alejandroescobar264/morfometria_craneos/README.md

# morfometria_craneos
Adquisición y Análisis de Datos Morfométricos Craneales Multidimensionales

Mejor visualización visitar [Wiki](https://alejandroescobar264.github.io/morfometria_craneos/).
