alejandroescobar264/morfometria_craneos/docs/modelos.md

# Modelos

## Todos Juntos

Muestras procesadas

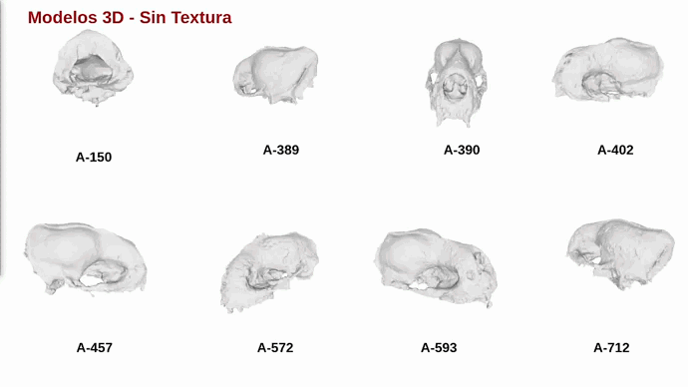
[picture p26: docs/img/GIF/Modelos_3D_Sin_Textura.gif]


## Individuales

### A-147

Muestras procesadas

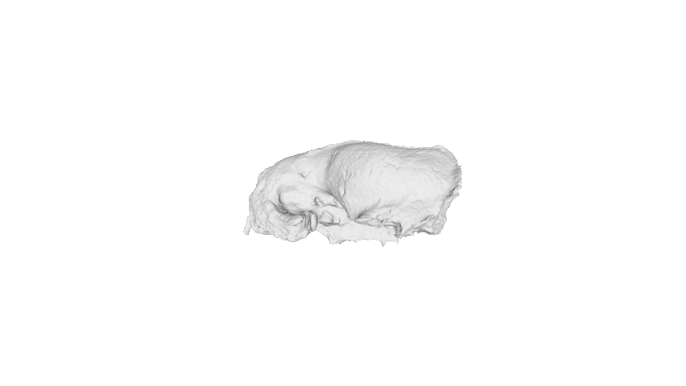
[picture p27: docs/img/GIF/A-147.gif]


### A-150

Muestras procesadas

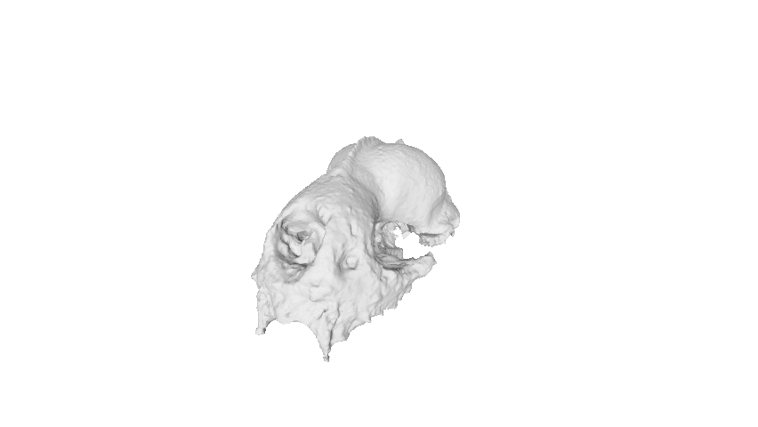
[picture p28: docs/img/GIF/A-150.gif]


### A-389

Muestras procesadas

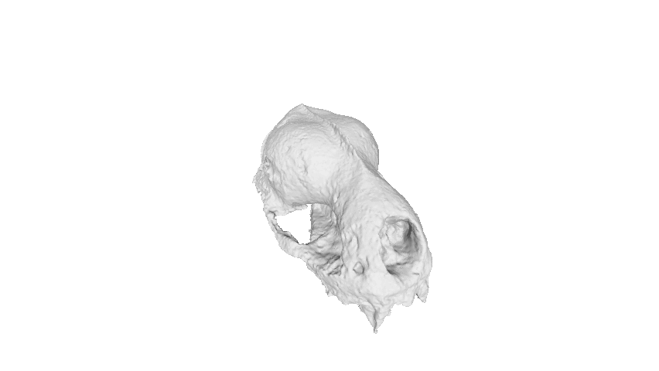
[picture p29: docs/img/GIF/A-389.gif]


### A-390

Muestras procesadas

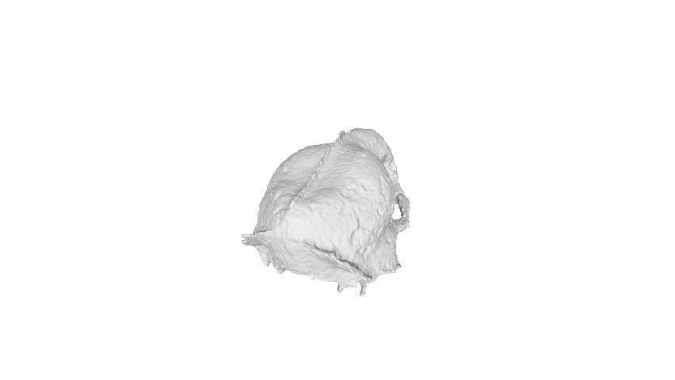
[picture p30: docs/img/GIF/A-390.gif]


### A-402

Muestras procesadas

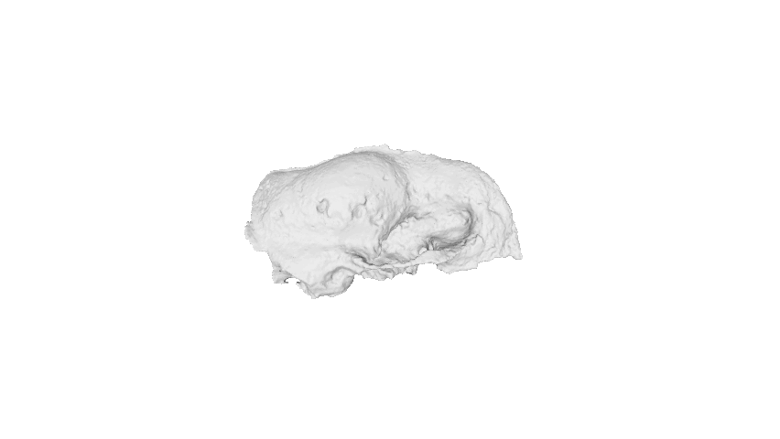
[picture p31: docs/img/GIF/A-402.gif]


### A-457

Muestras procesadas

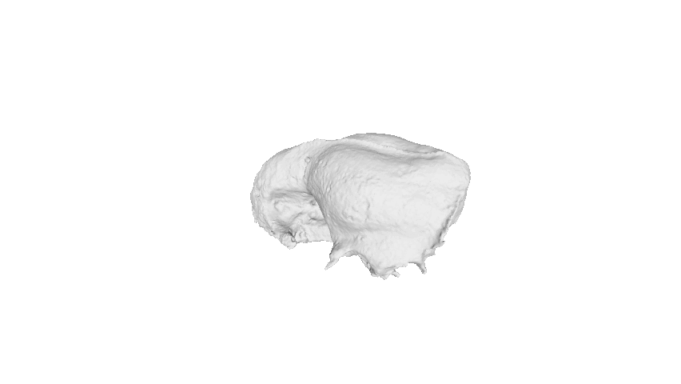
[picture p32: docs/img/GIF/A-457.gif]


### A-572

Muestras procesadas

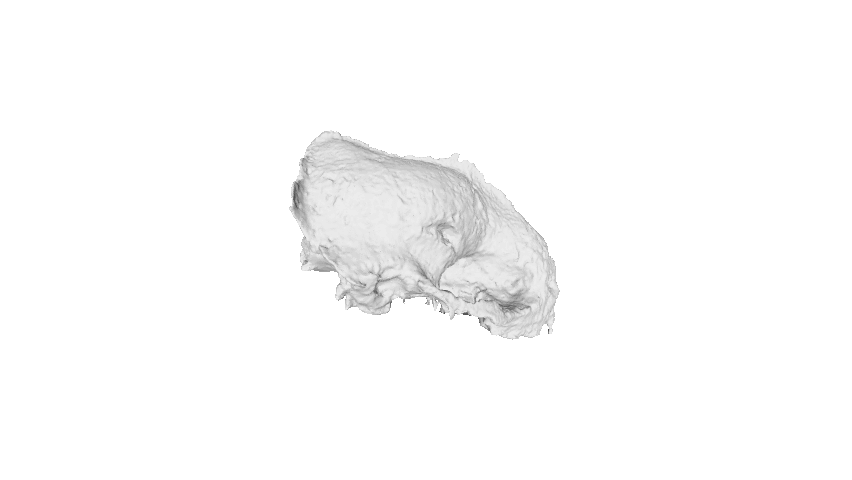
[picture p33: docs/img/GIF/A-572.gif]


### A-593

Muestras procesadas

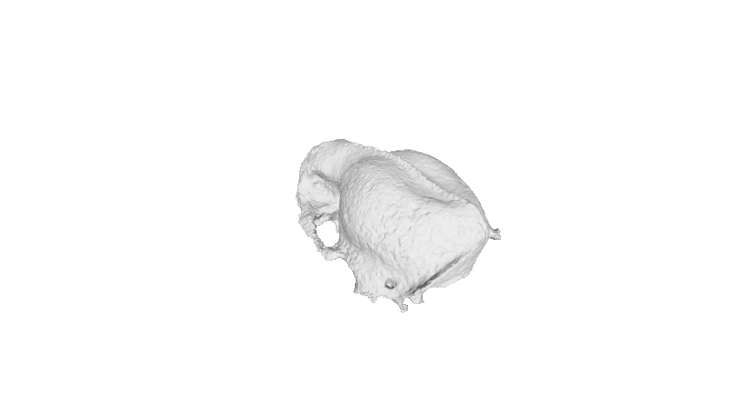
[picture p34: docs/img/GIF/A-593.gif]


### A-712

Muestras procesadas

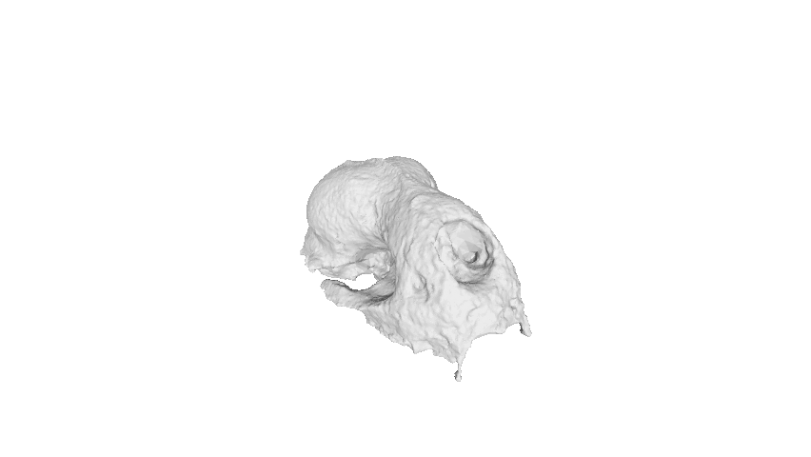
[picture p35: docs/img/GIF/A-712.gif]
