alejandroescobar264/morfometria_craneos/docs/resultado.md

# Resultados

## Versión 2.0

### Muestras Procesadas

Se observan a continuación las muestras elegidas:

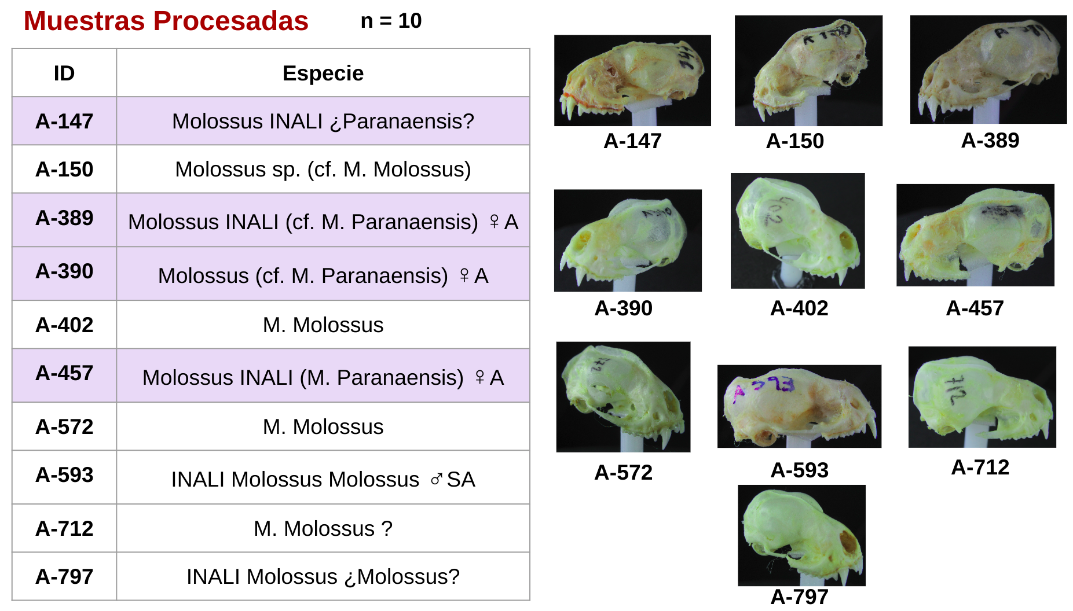
[picture p40: docs/img/muestras_procesadas.png]
Muestras procesadas


Se muestra a modo de ejemplo una de los modelos correspondiente a la muestra A-150, con y sin textura:

Muestras procesadas

Muestras procesadas

Las demás pueden observarse a continuación:

Muestras procesadas

Muestras procesadas

En el apartado de Modelos se pueden encontrar las muestras individuales.

## Análisis Morfométrico 3D

### Colocación de Landmarks 3D

Para la colocación de Landmarks se empleó el software libre 3D Slicer, particularmente la librería SliceMorph.

Se colocaron 24 landmarks craneales, 16 en el hueso nasal y 22 en la nuca.

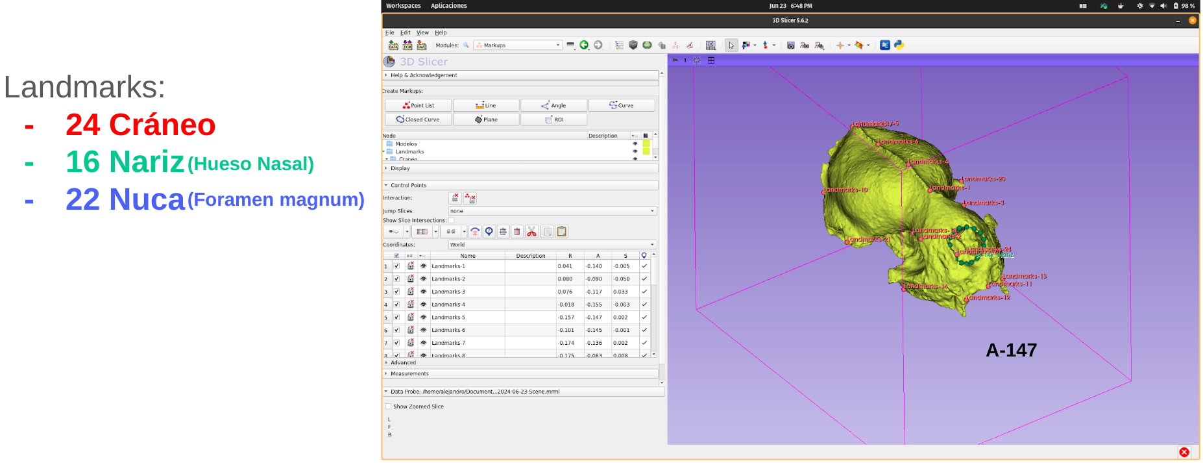
[picture p41: docs/img/3d_slicer.png]
3D Slicer - SliceMorph


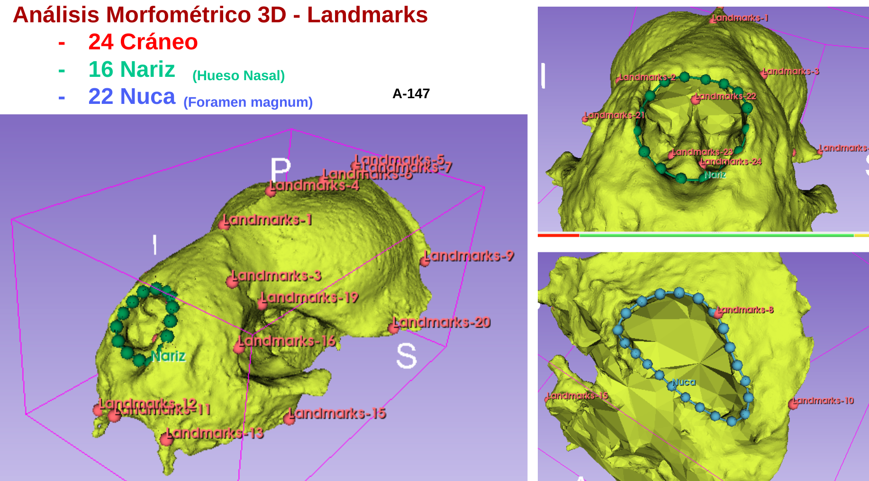
[picture p42: docs/img/landmarks.png]
Landmarks


Se empleó el complemento ALPACA para poder transferir los landmarks de una plantilla al resto de los modelos, ahorrando mucho tiempo de marcado manual.

Se muestran todo el conjunto de modelos con los landmarks transferidos.

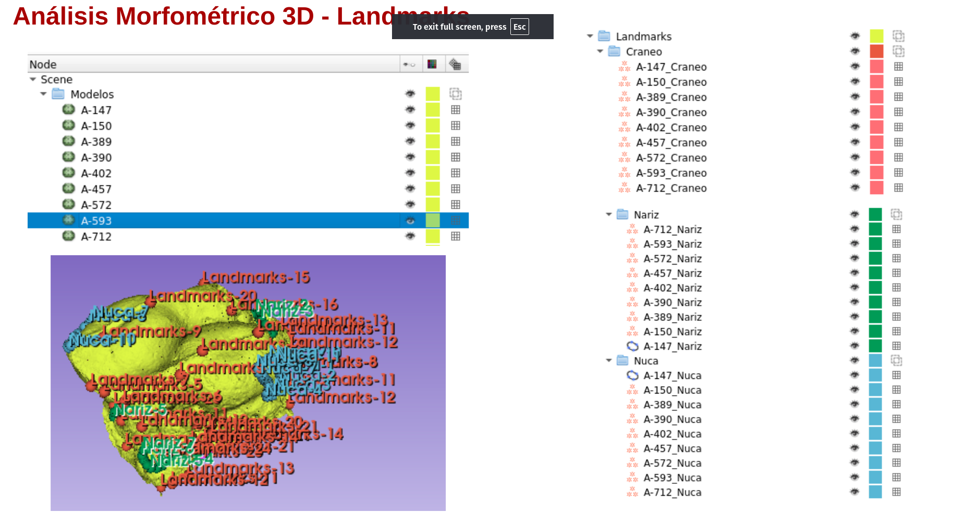
[picture p43: docs/img/landmarks_todos.png]
Landmarks


Se observa que los modelos no se encuentran en el mismo sistema de coordenadas, sin embargo, el analisis morfométrico se independiza del tamaño y no es necesario llevarlos todos al mismo sistema coordenado.

### Análisis de Procrustes Generalizado (GPA)

Se realizó el analisis de procrustes, obteniendose los siguientes resultados:

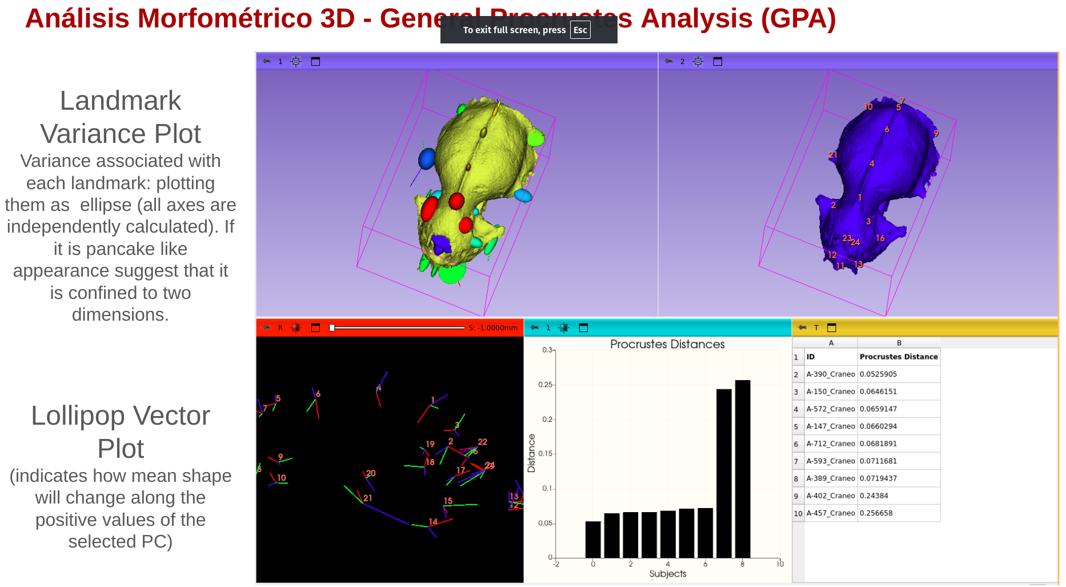
[picture p44: docs/img/procrustes_1.png]
Procrustes


Se muestra el plot de la variación de los landmarks en todos los modelos:

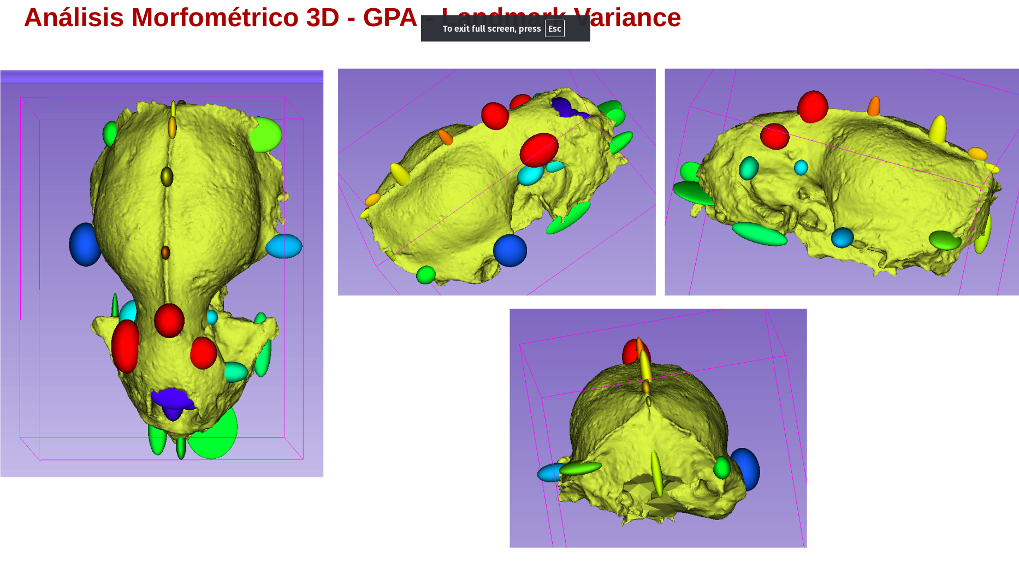
[picture p45: docs/img/procrustes_2.png]
Procrustes


#### Análisis del Cráneo

Se muestran los resultados del análisis de procrustes para los landmarks del cráneo:

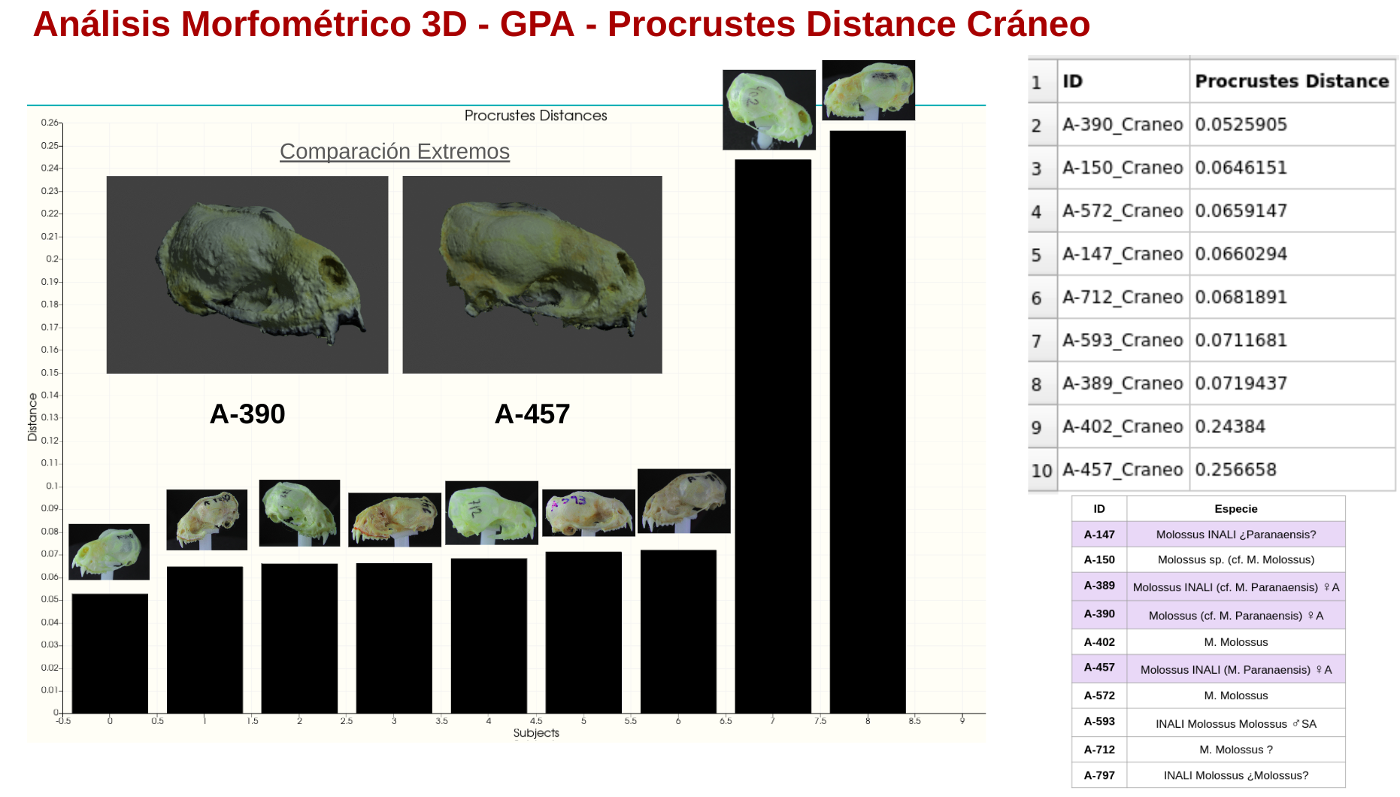
[picture p46: docs/img/procrustes_3.png]
Procrustes


#### Análisis de la Hueso Nasal

Se muestran los resultados del análisis de procrustes para los landmarks del hueso nasal:

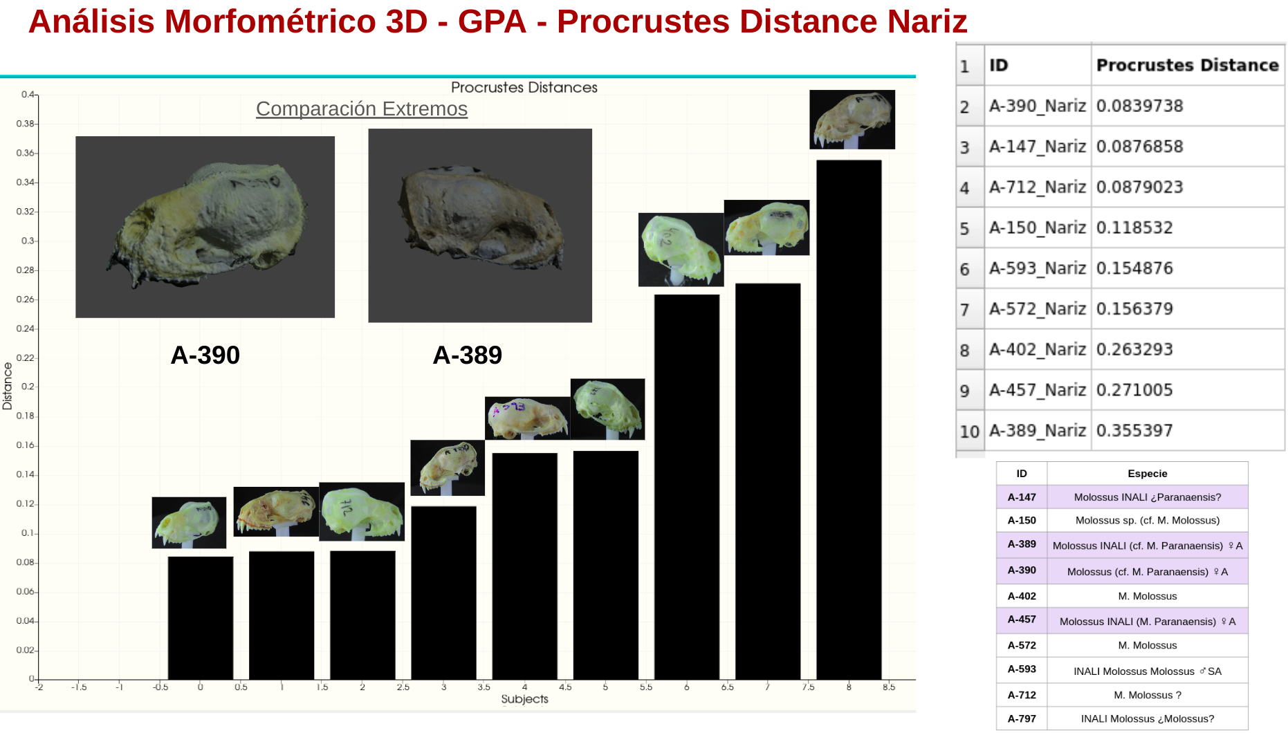
[picture p47: docs/img/procrustes_4.png]
Procrustes


#### Análisis del Foramen Magnum

Se muestran los resultados del análisis de procrustes para los landmarks del foramen magnum:

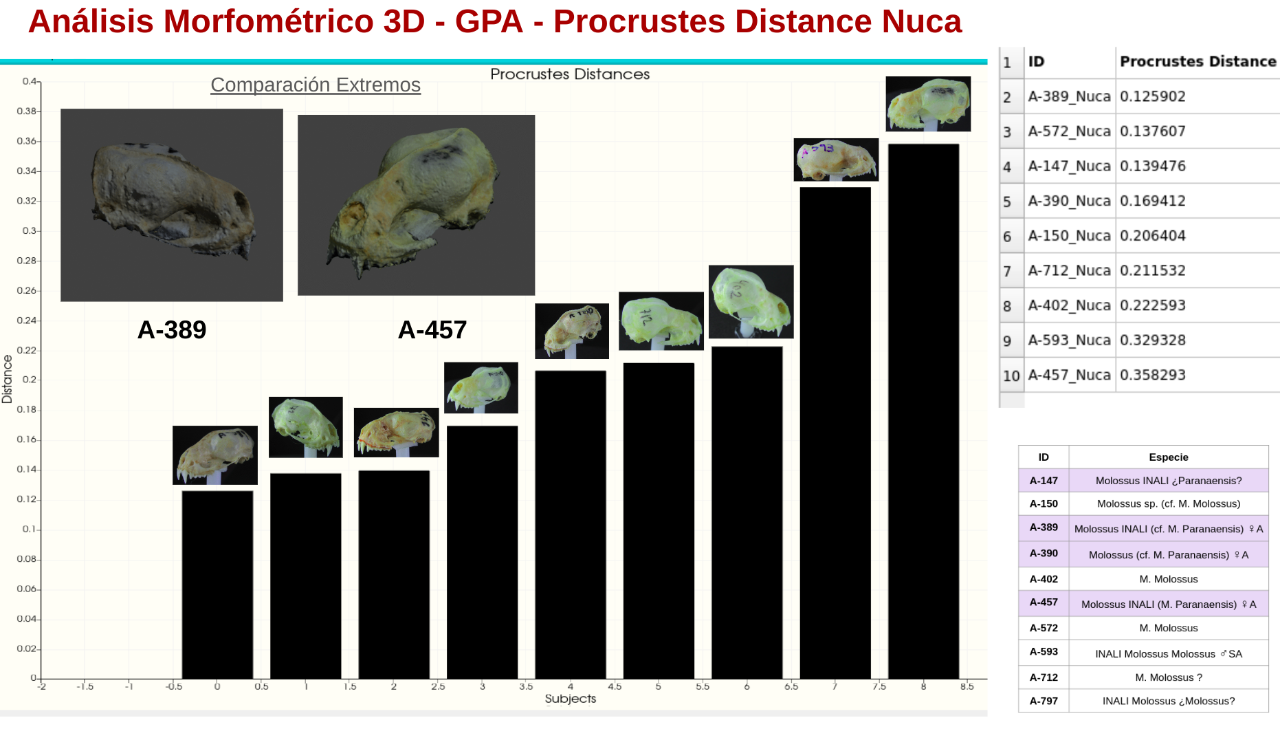
[picture p48: docs/img/procrustes_5.png]
Procrustes


### Alineamiento Simple

Se realizó un alineamiento simple entra las muestras A-147 y A-150 para observar las diferencias en las estructuras:

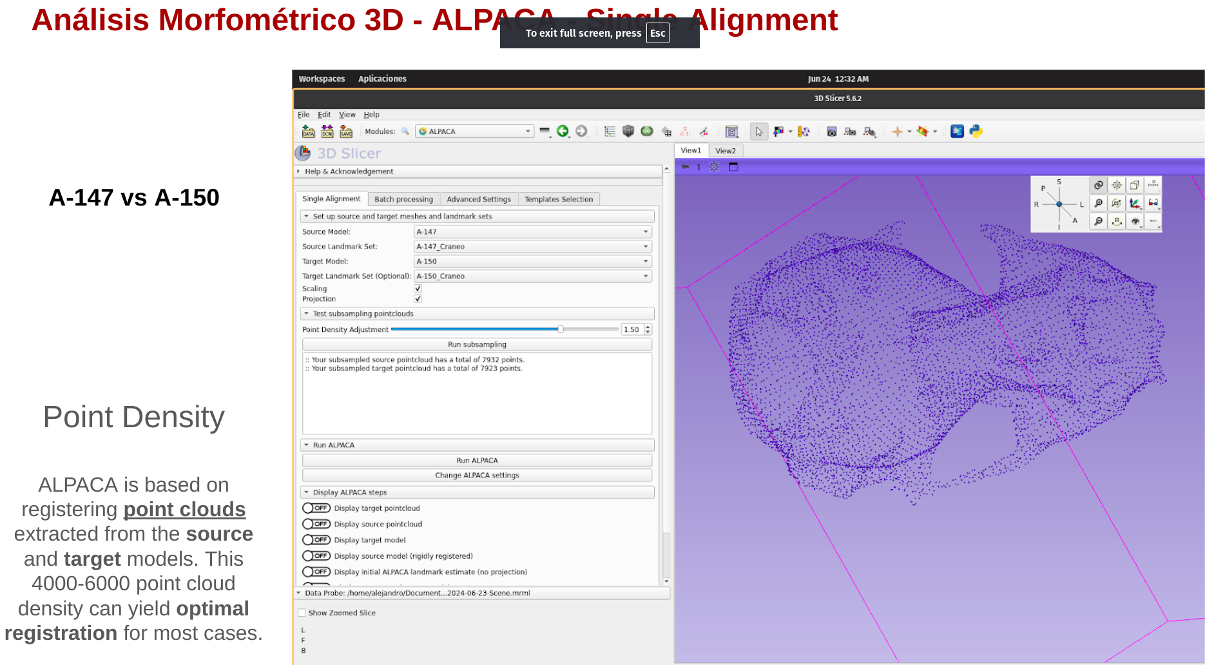
[picture p49: docs/img/alineamiento_1.png]
Alineamiento Simple


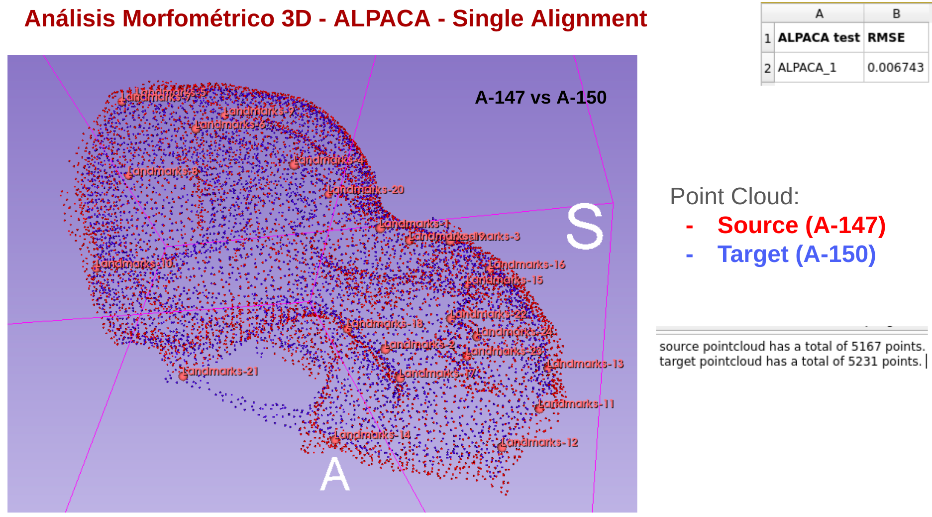
[picture p50: docs/img/alineamiento_2.png]
Alineamiento Simple


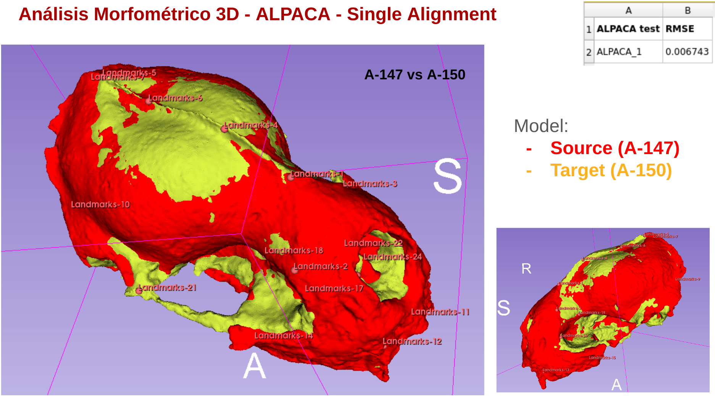
[picture p51: docs/img/alineamiento_3.png]
Alineamiento Simple
